rogermeier/Altair8800-IOBus-Cards/README.md

# Altair8800-IOBus-Cards
I/O bus cards for Altair 8800 Simulator, compatible with dhansel/Altair8800-IOBus

This is a repository for I/O bus cards for the Altair 8800 Simulator, adding to David Hansel's offering at https://github.com/dhansel/Altair8800-IOBus.
