rogermeier/Altair8800-IOBus-Cards/xx-IOBus-KiCAD-Template/README.md

## IOBus Card Template for KiCAD

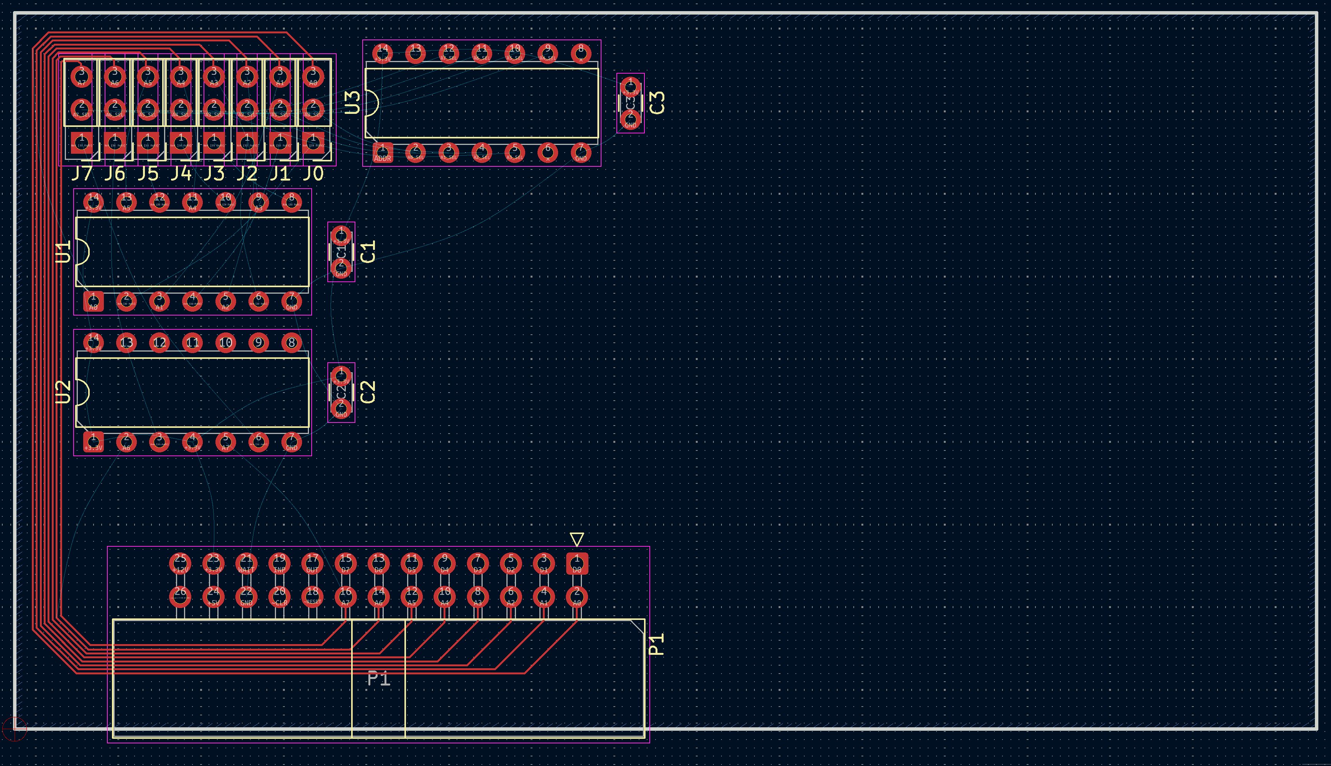
[picture p2: xx-IOBus-KiCAD-Template/IO-card-template.png]
IO-card-template


KiCAD starter project to design your own IO card compatible with David Hansel's Altair 8800 Simulator IOBus ecosystem (Info: https://github.com/dhansel/Altair8800-IOBus).
