rogermeier/Altair8800-IOBus-Cards/00-powered-backplane/schematic.pdf

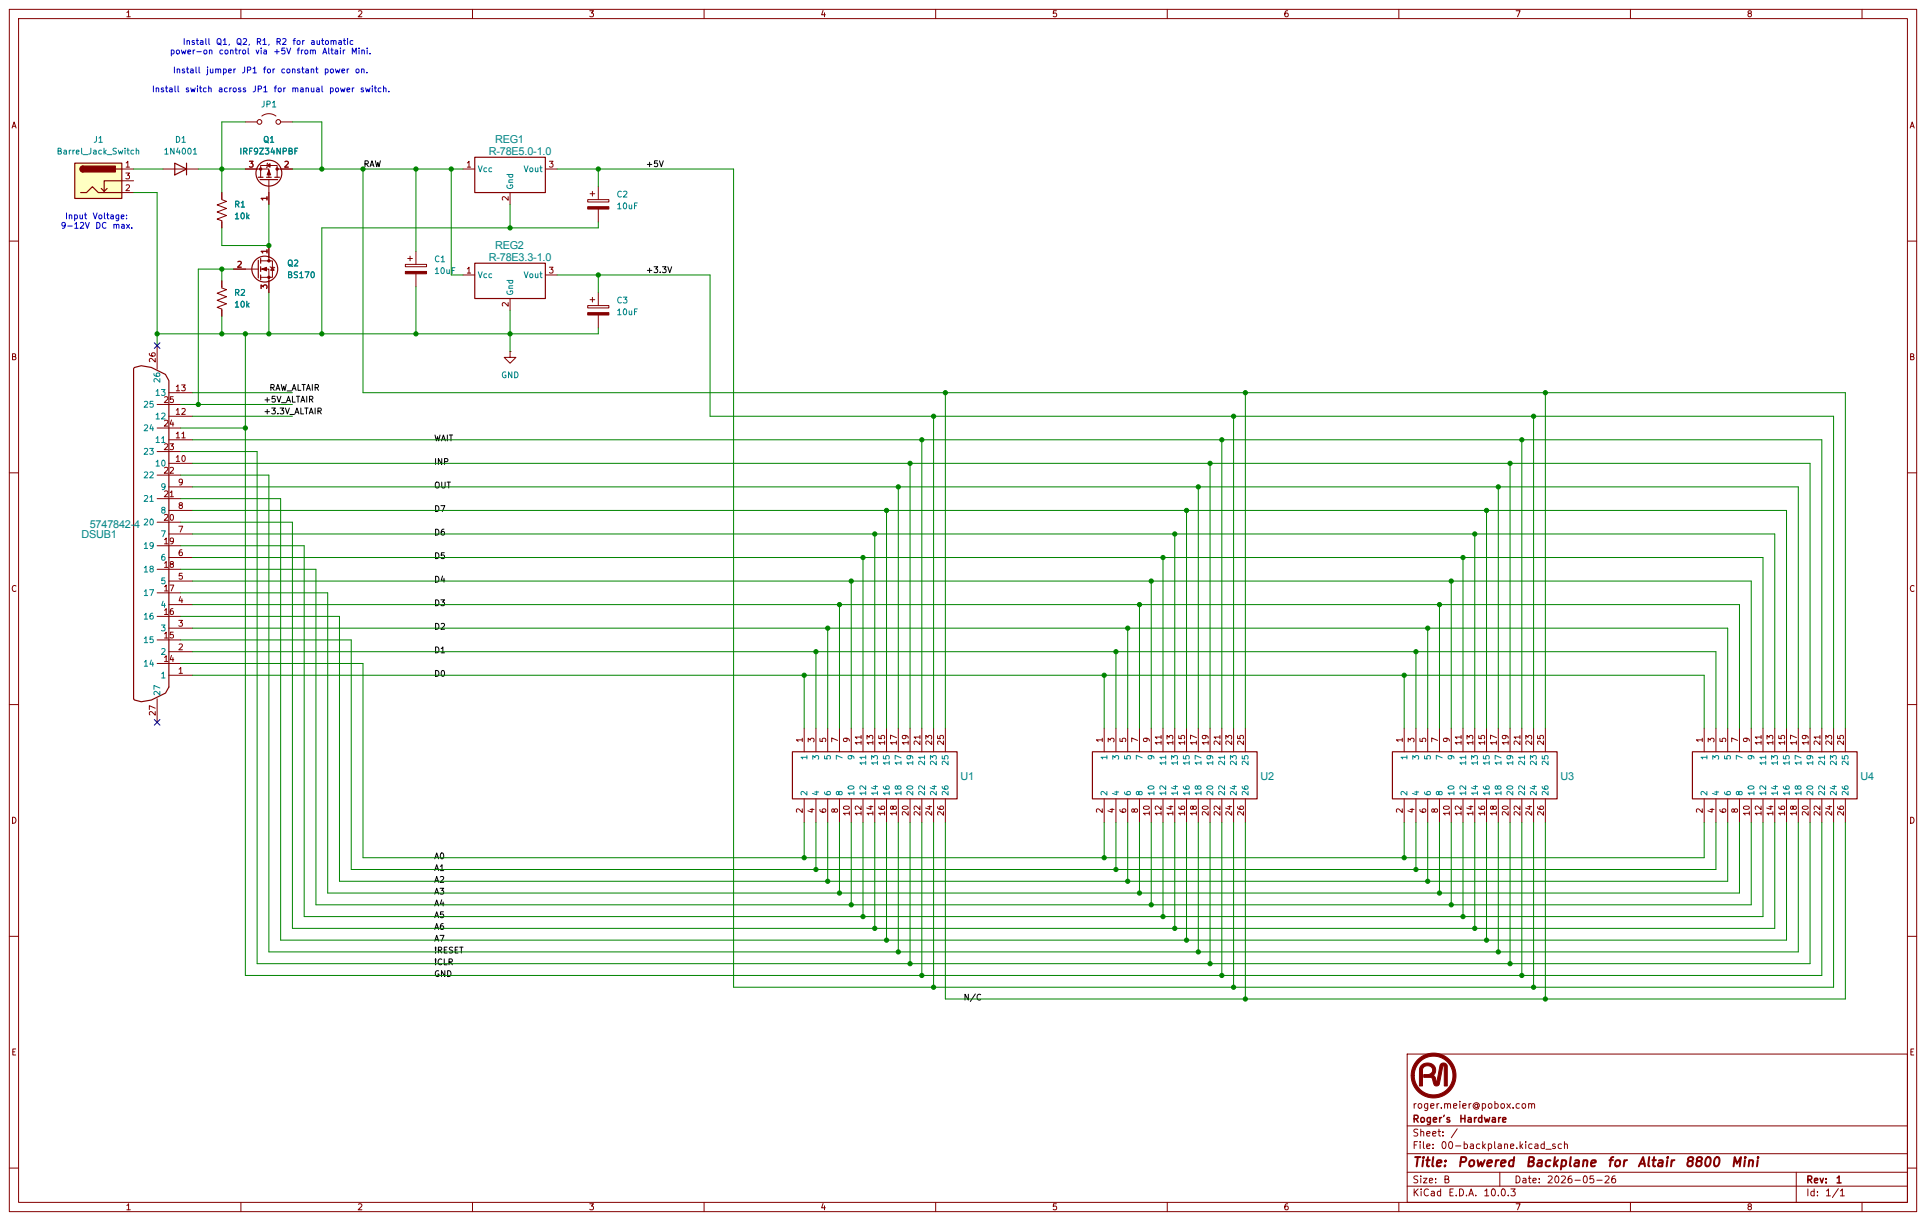
[picture p4: page 1]

Install Q1, Q2, R1, R2 for automatic power-on control via +5V from Altair Mini.

Install jumper JP1 for constant power on.

Install switch across JP1 for manual power switch. Q1

Input Voltage: 9-12V DC max.

!RESET A5D1

roger.meier@pobox.com
Roger's Hardware
Sheet: /
File: 00-backplane.kicad_sch
Title: Powered Backplane for Altair 8800 Mini

Size: B | Rev: 1
KiCad E.D.A. 10.0.3 | Id: 1/1
