rogermeier/Altair8800-IOBus-Cards/xx-IOBus-KiCAD-Template/schematic.pdf

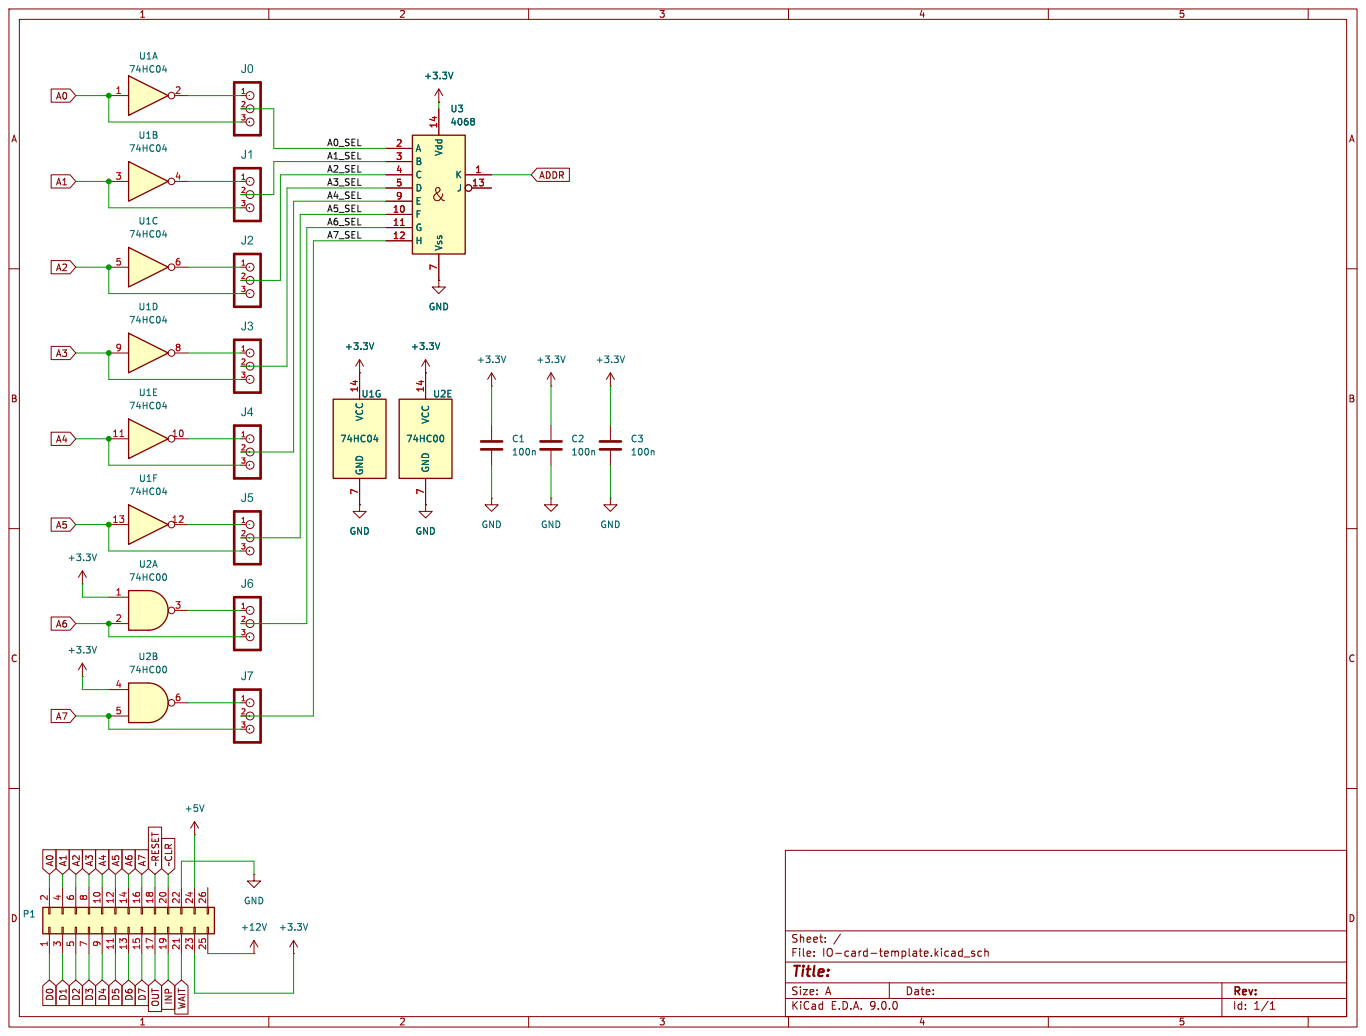
[picture p5: page 1]
