rogermeier/Altair8800-IOBus-Cards/11-sense-switch-input/schematic.pdf

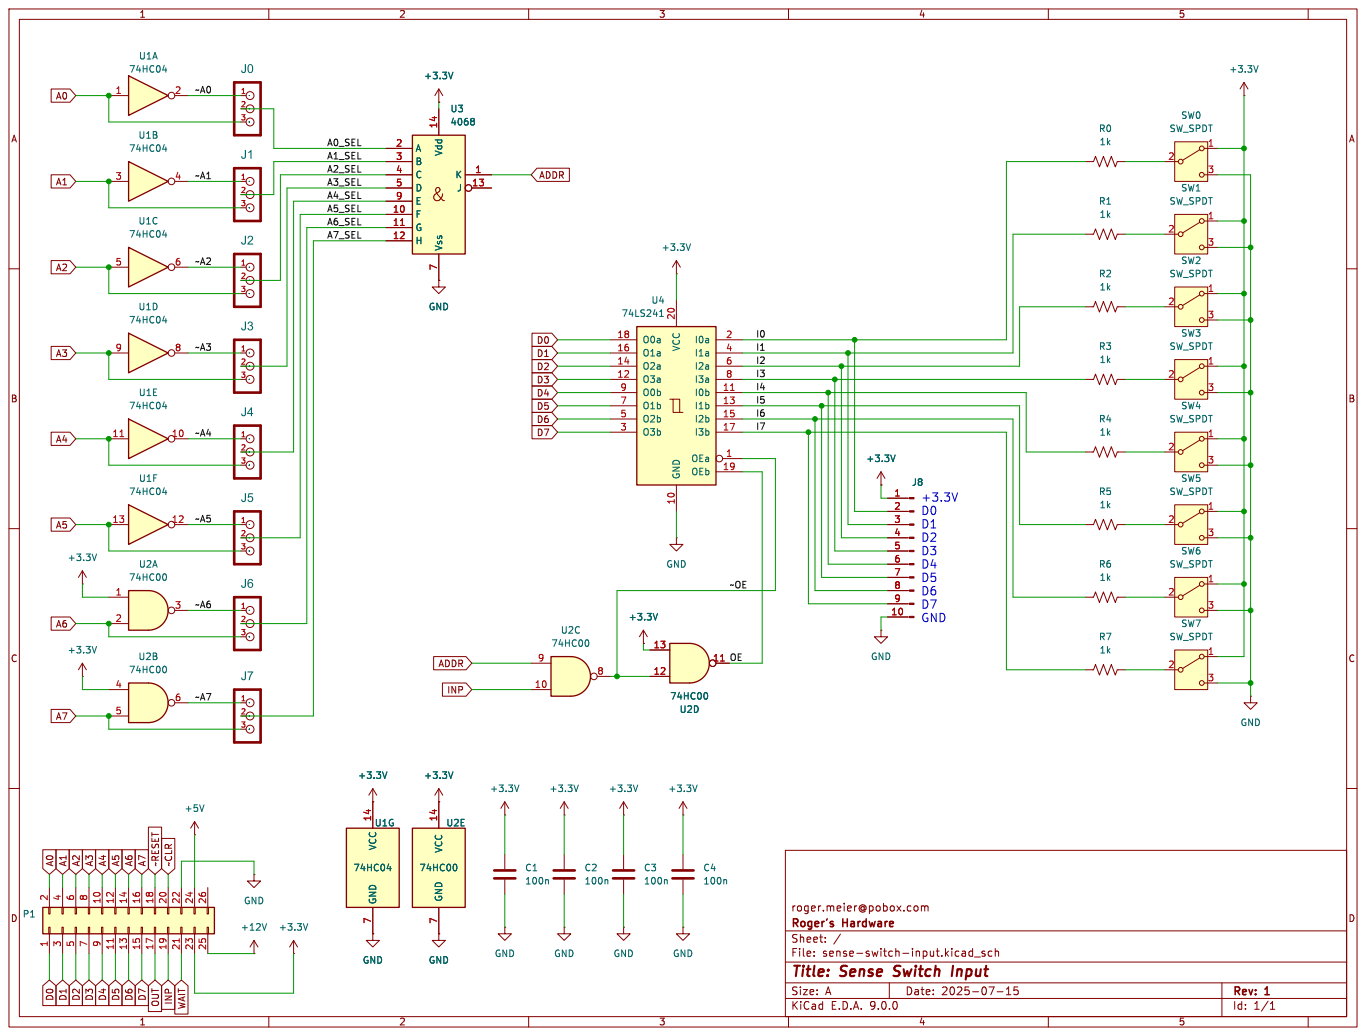
[picture p6: page 1]
