rogermeier/Altair8800-IOBus-Cards/xx-IOBus-KiCAD-Template/IO-card-template/IO-card-template.kicad_pcb

## KiCad design xx-IOBus-KiCAD-Template/IO-card-template/IO-card-template.kicad_pcb (2025-09-01)

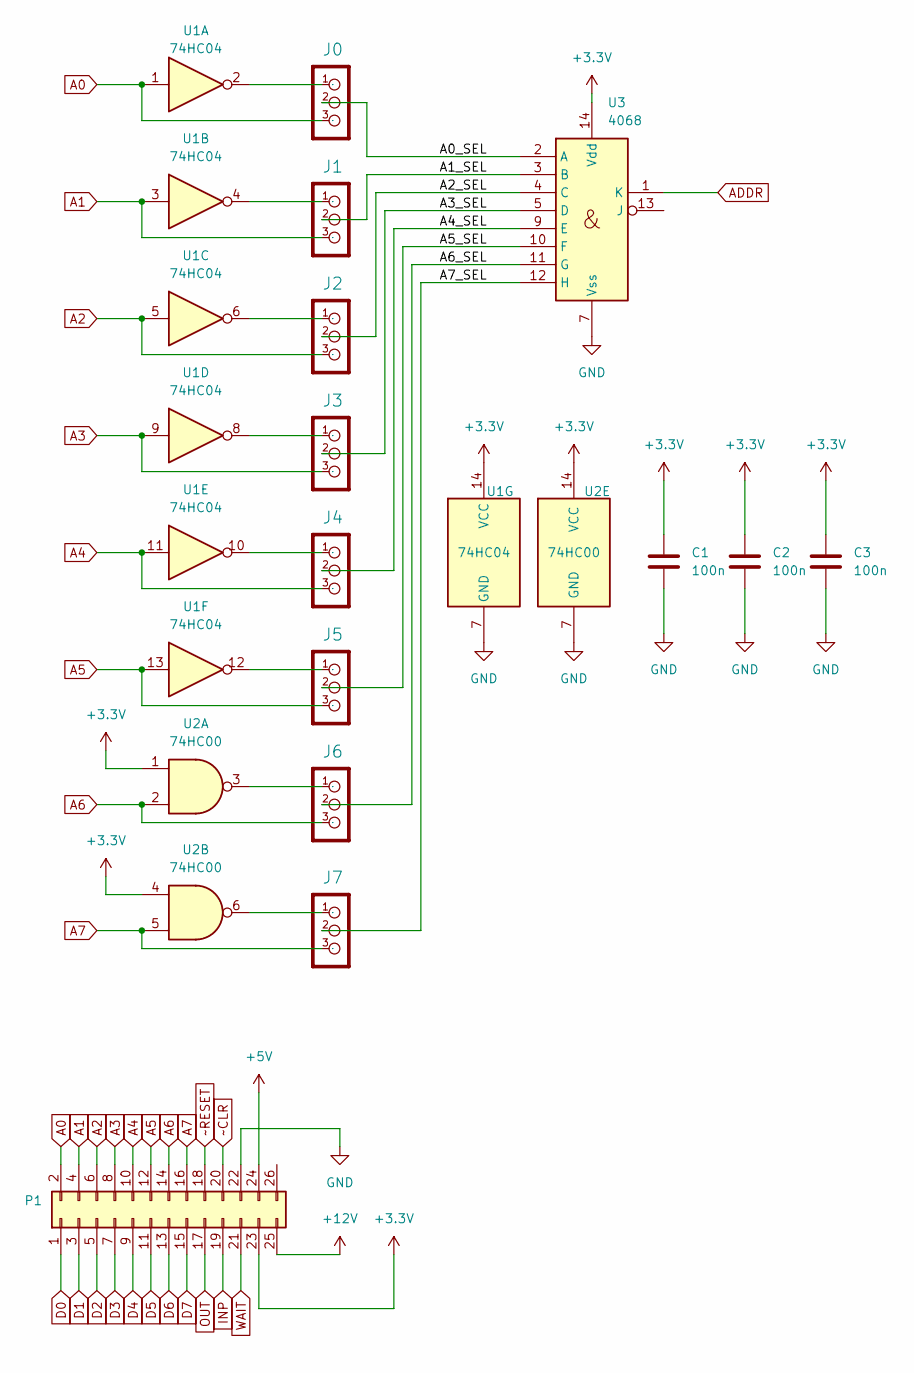
[picture p7: schematic IO-card-template.kicad_sch]

Parts:
C1, C2, C3: 100n; C_Disc_D3.0mm_W1.6mm_P2.50mm
J0, J1, J2, J3, J4, J5, J6, J7: CON_HEADER_1X03-PTH; PinHeader_1x03_P2.54mm_Vertical
P1: Conn_02x13_Odd_Even; IDC-Header_2x13_P2.54mm_Horizontal
U1: 74HC04; DIP-14_W7.62mm
U2: 74HC00; DIP-14_W7.62mm
U3: 4068; DIP-14_W7.62mm

Connections:
+3.3V: C1.1, C2.1, C3.1, P1.23, U1.14 (VCC), U2.1, U2.4, U2.14 (VCC), U3.14 (Vdd)
+5V: P1.24
+12V: P1.25
/A0_SEL: J0.2, U3.2 (A)
/A1_SEL: J1.2, U3.3 (B)
/A2_SEL: J2.2, U3.4 (C)
/A3_SEL: J3.2, U3.5 (D)
/A4_SEL: J4.2, U3.9 (E)
/A5_SEL: J5.2, U3.10 (F)
/A6_SEL: J6.2, U3.11 (G)
/A7_SEL: J7.2, U3.12 (H)
A0: J0.3, P1.2, U1.1
A1: J1.3, P1.4, U1.3
A2: J2.3, P1.6, U1.5
A3: J3.3, P1.8, U1.9
A4: J4.3, P1.10, U1.11
A5: J5.3, P1.12, U1.13
A6: J6.3, P1.14, U2.2
A7: J7.3, P1.16, U2.5
ADDR: U3.1 (K)
D0: P1.1
D1: P1.3
D2: P1.5
D3: P1.7
D4: P1.9
D5: P1.11
D6: P1.13
D7: P1.15
GND: C1.2, C2.2, C3.2, P1.22, U1.7 (GND), U2.7 (GND), U3.7 (Vss)
INP: P1.19
unnamed: J0.1, U1.2
unnamed: J1.1, U1.4
unnamed: J2.1, U1.6
unnamed: J3.1, U1.8
unnamed: J4.1, U1.10
unnamed: J5.1, U1.12
unnamed: J6.1, U2.3
unnamed: J7.1, U2.6
OUT: P1.17
WAIT: P1.21
~CLR: P1.20
~RESET: P1.18

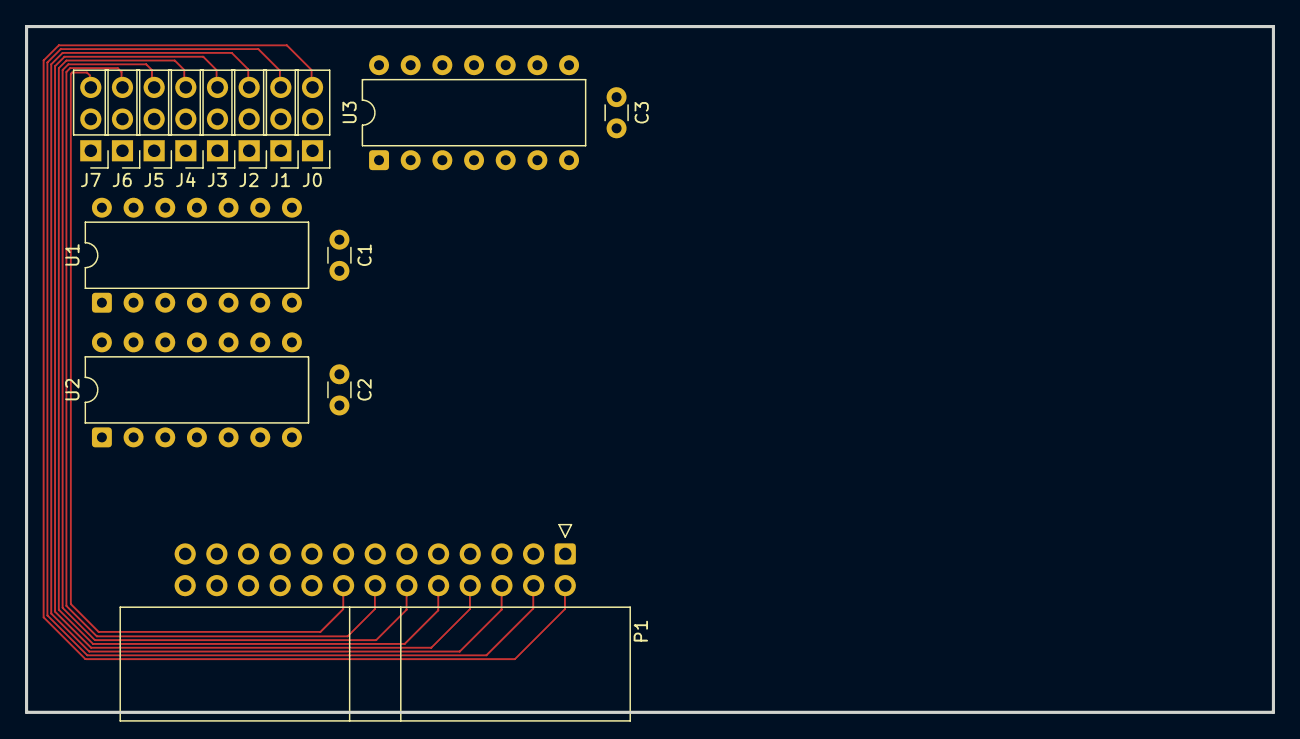
[picture p8: board IO-card-template.kicad_pcb from above]

Board: 2 copper layers, 100.0 x 55.0 mm, 15 parts (0 on the bottom side), 26 nets.
